quuuiur/PulseOX/WechatMiniProgram/slides_output/esp32_ble_wechat_miniprogram_lesson.pptx

从传感器到微信小程序：BLE 通信层如何搭起来

本节课只讲通信链路：为什么选 BLE、协议怎么定、两端代码怎么写。

这不是“把串口搬到手机”，而是把 ESP32 变成可订阅的数据服务。

Source: Arduino / WeChat Mini Program source code; WeChat Mini Program BLE docs

LECTURE MAP

ESP32 Peripheral

MAX30102 采样
心率/SpO2 本地计算
BLE notify 推送

脉搏血氧仪

>

SpO2

97

HR

82

ESP32 端：保留测量算法，新增 NimBLE GATT Server

小程序端：扫描、连接、订阅 notify、解析二进制包

4-byte wave + 6-byte metrics

课堂扩展：每组用独立 AppID、设备名、UUID

WeChat Mini Program

BLE Central
订阅两个 Characteristic
Canvas 绘制波形

>

01

## Slide 2

ESP32 有两条蓝牙路线，但手机端框架决定了选择。

Classic SPP 很像无线串口；BLE 是面向低功耗外设的数据服务模型。

从“发字符串”转向“定义服务、特征值和数据包”。

Source: Arduino / WeChat Mini Program source code; WeChat Mini Program BLE docs

BLUETOOTH CHOICE

维度

经典蓝牙 SPP

蓝牙 BLE

本项目判断

连接模型

点对点串口链路

Peripheral / Central + GATT

手机小程序按 GATT 连接

数据方式

连续字节流，像 Serial

Service / Characteristic / notify

波形与指标拆成两个 notify

跨平台难度

iOS 对 SPP 支持受限

iOS / Android 都有 BLE API

适合不同学生手机

功耗与频率

吞吐高但更重

适合几十 Hz 小包通知

50 点/秒波形足够

微信小程序

不能直接用 SPP

支持 BLE 低功耗接口

因此选择 BLE

手机端框架把项目推向 BLE GATT

02

## Slide 3

用微信小程序，是为了把手机端差异收敛到一个轻量框架。

Source: Arduino / WeChat Mini Program source code; WeChat Mini Program BLE docs

APP STRATEGY

原生 iOS App

Swift / 证书 / TestFlight / CoreBluetooth

>

原生 Android App

Kotlin/Java / 权限模型 / 机型差异

>

Web 页面

浏览器蓝牙能力和微信环境限制

>

微信小程序

统一入口；用真机调试 BLE；学生易分发

代价：小程序端的蓝牙能力是 BLE API，不是传统蓝牙串口。

因此 ESP32 必须做 BLE Peripheral/GATT Server；小程序作为 Central 扫描和订阅 notify。

03

## Slide 4

BLE 不是串口；它是“服务目录 + 可订阅字段”的模型。

Source: Arduino / WeChat Mini Program source code; WeChat Mini Program BLE docs

BLE MENTAL MODEL

Peripheral

ESP32-PulseOX
广播名字和 Service UUID

订阅 notify 后，ESP32 主动推送；小程序在 onBLECharacteristicValueChange 中收到 ArrayBuffer。

GATT Service

Wave Characteristic

READ | NOTIFY
4 字节波形包，约 50Hz

7D6E0001-...-3032

>

Metrics Characteristic

READ | NOTIFY
6 字节心率/血氧包

Central

微信小程序
扫描、连接、订阅

>

04

## Slide 5

测量仍在 ESP32 本地完成，BLE 只传显示层需要的数据。

Source: Arduino / WeChat Mini Program source code; WeChat Mini Program BLE docs

SYSTEM ARCHITECTURE

MAX30102

red / IR samples
400 SPS

Filters

LPF / HPF
Differentiator

Algorithm

BPM + SpO2
averaging

BLE GATT

wave notify
metrics notify

Mini Program

parse packets
update UI

Canvas + values

PPG curve
HR / SpO2

>

>

>

>

>

原串口屏链路不删除：Serial2 仍然向组态屏发送同一份波形和数值。

新增手机链路不重算算法：只在既有事件点调用 notifyWave / notifyMetrics。

05

## Slide 6

协议越小，越适合 BLE 默认 20 字节 MTU 和课堂调试。

Source: Arduino / WeChat Mini Program source code; WeChat Mini Program BLE docs

APPLICATION PROTOCOL

Wave packet: 4 bytes

含义

Metrics packet: 6 bytes

含义

Byte

0

字段

type

固定 0x01

Byte

0

字段

type

固定 0x02

1

seq

波形序号，0-255 循环

1-2

bpm

uint16 little-endian

2

3

value

flags

显示波形值，0-120

bit0: fingerDetected

由 400SPS 采样每 8 点平均一次，约 50 点/秒。

3

4

spo2

flags

uint8, 0-100

bit0 手指；bit1 指标有效

5

seq

当前波形序号

心率/血氧只在平均结果有效后推送；刚放手指会先显示 --。

二进制包比 JSON 更短、更稳定、更容易按字节讲解

06

## Slide 7

NimBLE-Arduino 负责把 ESP32 发布成一个可被订阅的 BLE 外设。

Source: Arduino / WeChat Mini Program source code; WeChat Mini Program BLE docs

ARDUINO SETUP

#include <NimBLEDevice.h>

const char *kBleDeviceName = "ESP32-PulseOX";

const char *kBleServiceUUID = "7d6e0001-...";

const char *kBleWaveCharacteristicUUID = "7d6e0002-...";

const char *kBleMetricsCharacteristicUUID = "7d6e0003-...";

NimBLEDevice::init(kBleDeviceName);

bleServer = NimBLEDevice::createServer();

NimBLEService *pulseService =

bleServer->createService(kBleServiceUUID);

waveCharacteristic = pulseService->createCharacteristic(

kBleWaveCharacteristicUUID, READ | NOTIFY, 4);

metricsCharacteristic = pulseService->createCharacteristic(

kBleMetricsCharacteristicUUID, READ | NOTIFY, 6);

第一层：身份

设备名用于学生肉眼识别；Service UUID 用于程序精确匹配。

第二层：数据字段

Wave 和 Metrics 是两个 Characteristic；都支持 READ 和 NOTIFY。

第三层：广播

advertising->addServiceUUID(...); advertising->start();

课堂讲法：先让学生在 nRF Connect 中看到服务目录，再回到小程序代码。

07

## Slide 8

BLE 发送点挂在原有测量事件上，避免维护两套算法。

Source: Arduino / WeChat Mini Program source code; WeChat Mini Program BLE docs

ARDUINO RUNTIME

readSample()

读取 red / IR

v

filter + diff

LPF / HPF / zero crossing

v

notifyWave()

4-byte 包

v

notifyMetrics()

6-byte 包

v

finger detect

red > threshold

v

PPGcount >= 8

map 到 0-120

v

avg ready

5 次心跳后

if (PPGcount >= 8) {

int display_val = map(..., -500, 500, 0, 120);

Serial2.print("add s0.id,0," + String(display_val) + ...);

notifyWave(display_val, true);

}

if (averager_bpm.count() >= kSampleThreshold) {

latestAverageBpm = average_bpm;

latestAverageSpo2 = clampInt(average_spo2, 0, 100);

notifyMetrics(latestAverageBpm, latestAverageSpo2, true, true);

}

08

## Slide 9

小程序端是一个严格的 BLE 状态机：先发现，再连接，再订阅。

代码锚点：startScan() -> connectDevice() -> discoverServices() -> discoverCharacteristics() -> subscribeNotifications()

Source: Arduino / WeChat Mini Program source code; WeChat Mini Program BLE docs

MINI PROGRAM FLOW

openBluetoothAdapter

初始化蓝牙模块

startBluetoothDevicesDiscovery

扫描附近 BLE 外设

createBLEConnection

连接 deviceId

getBLEDeviceServices

找到 Service UUID

>

>

>

getBLEDeviceCharacteristics

找到 Wave / Metrics

>

notifyBLECharacteristicValueChange

启用 notification

>

onBLECharacteristicValueChange

接收 ArrayBuffer

v

09

## Slide 10

小程序把 notify 的 ArrayBuffer 解析成 UI 状态和波形数组。

Source: Arduino / WeChat Mini Program source code; WeChat Mini Program BLE docs

MINI PROGRAM CODE

handleBleValueChange(result) {

const id = normalizeUuid(result.characteristicId)

const view = new DataView(result.value)

if (id === WAVE_CHARACTERISTIC_UUID) {

this.handleWavePacket(view)

} else if (id === METRICS_CHARACTERISTIC_UUID) {

this.handleMetricsPacket(view)

}

}

Wave parser

type=0x01
byte2 -> waveValue
byte3 bit0 -> finger

Metrics parser

type=0x02
bytes1-2 -> bpm
byte3 -> spo2

>

脉搏血氧仪

wavePoints.shift()

wavePoints.push(waveValue)

this.drawWave()

ctx.lineTo(x, y) // Canvas curve

SpO2

97

HR

82

核心观念：小程序不计算心率，只负责连接、解析、显示。

10

## Slide 11

14 个小组同时运行时，要分清“账号归属”和“蓝牙隔离”。

DEVICE_NAME_PREFIX = ESP32-PulseOX-G03 SERVICE_UUID = 7D6E0301-... WAVE = 7D6E0302-... METRICS = 7D6E0303-...

Source: Arduino / WeChat Mini Program source code; WeChat Mini Program BLE docs

CLASSROOM SCALE

AppID

决定小程序属于谁。
每组注册自己的小程序或使用测试号。

BLE name

决定人眼和扫描列表里看到哪台设备。
例如 ESP32-PulseOX-G03。

BLE UUIDs

决定程序精确连接哪组服务和特征值。
Service / Wave / Metrics 都要唯一。

G03 示例

Arduino 端和小程序端四个常量必须一一对应

11

## Slide 12

调试时不要猜，按通信链路逐层定位。

Source: Arduino / WeChat Mini Program source code; WeChat Mini Program BLE docs

DEBUGGING MAP

1. ESP32 广播

串口监视器看到 advertising；nRF Connect 能扫到设备名

2. 手机权限

手机蓝牙打开；Android 给微信定位/附近设备权限

3. Service 匹配

小程序能连接，但若提示未找到服务，检查 SERVICE_UUID

4. notify 订阅

能连接但没数据，检查 Characteristic UUID 和 notify 属性

5. 数据解析

有包但 UI 不变，检查 type 字节、长度和小端序

6. 算法输入

有波形但无 BPM/SpO2，检查手指放置、阈值、平均样本数

12
