quuuiur/PulseOX/WechatMiniProgram/slides_output/esp32_ble_wechat_miniprogram_lesson_expanded.pptx

基于蓝牙通信和微信小程序实现心率、血氧和脉搏波的手机端显示

LECTURE MAP

ESP32 Peripheral

MAX30102 采样
心率/SpO2 本地计算
BLE notify 推送

脉搏血氧仪

>

SpO2

97

HR

82

4-byte wave + 6-byte metrics

WeChat Mini Program

BLE Central
订阅两个 Characteristic
Canvas 绘制波形

>

01

## Slide 2

蓝牙先解决“近距离无线交换数据”，但不规定你一定像串口那样发。

蓝牙中涉及通用数据传输协议的有两种：
- SPP(Serial Port Profile)协议
- BLE(Bluetooth low energy)协议

BLUETOOTH FIRST PRINCIPLES

连接前

设备要让别人发现自己：名字、地址、服务线索。

连接中

两端协商角色和通信方式，决定如何交换数据。

连接后

真正的差异出现：可能是字节流，也可能是服务字段。

>

>

同一个“蓝牙”名字下面，有不同的通信模型。

本课只对比和项目有关的两种：经典蓝牙 SPP，以及 BLE GATT。

02

## Slide 3

SPP 可以先理解成：把一根串口线换成无线。

这就是很多单片机项目喜欢 SPP 的原因：思维模型接近 Serial.print。

Source: Arduino / WeChat Mini Program source code; WeChat Mini Program BLE API docs

CLASSIC BLUETOOTH SPP

单片机侧

UART TX/RX
一串连续字节
Serial.print(...)

SPP 链路

配对后像打开一个
无线串口通道

手机 App 侧

App 读取字节流
自己决定如何分包

>

>

优点：概念直观，和串口屏/串口助手很像。

难点：手机端尤其 iOS/微信小程序并不把 SPP 当作统一开放能力。

SPP 思维：我只管不停发字节

03

## Slide 4

BLE 更像“设备把数据字段公布出来，手机按需订阅”。

它不是默认给你一条连续串口流，而是鼓励低功耗、小数据包、明确字段。

Source: Arduino / WeChat Mini Program source code; WeChat Mini Program BLE API docs

BLE MENTAL MODEL

wave 字段

当前波形点
支持 READ / NOTIFY

BLE 外设

我叫 ESP32-PulseOX
我有一个 PulseOX 服务
里面有 wave 和 metrics 两个字段

>

v

手机小程序

扫描设备
连接服务
订阅字段变化
收到 notify 后刷新 UI

>

metrics 字段

心率、血氧、状态
支持 READ / NOTIFY

v

BLE GATT 思维：字段有名字、有 UUID、有权限、有通知

04

## Slide 5

BLE 连接前先分角色：谁广播，谁扫描。

本项目里 ESP32 是 Peripheral，小程序是 Central。

先广播，不代表已经连接。

小程序扫描到设备后，还要按 UUID 找到真正的数据服务。

Source: Arduino / WeChat Mini Program source code; WeChat Mini Program BLE API docs

BLE ROLES

Peripheral 外设

通常是传感器、手环、血氧仪这类设备。
它主动广播：我在这里，我叫什么，我有哪些服务。

广播包 Advertising

name = ESP32-PulseOX
service = 7D6E0001...
interval = 周期发送

Central 中心设备

通常是手机、电脑、网关。
它负责扫描、筛选、连接、发现服务、订阅数据。

>

>

05

## Slide 6

GATT 可以理解成一本“蓝牙数据目录”。

目录里不是随便放文本，而是用 UUID 标识服务和字段。

一句话：Service 是一类功能，Characteristic 是可读/可通知的数据字段，UUID 是双方约定的编号。

Source: Arduino / WeChat Mini Program source code; WeChat Mini Program BLE API docs

GATT VOCABULARY

GATT Service

Characteristic: Wave

UUID: 7D6E0002-...
Properties: READ | NOTIFY
Value: 4-byte packet

Service UUID: 7D6E0001-...

Characteristic: Metrics

UUID: 7D6E0003-...
Properties: READ | NOTIFY
Value: 6-byte packet

06

## Slide 7

SPP 和 GATT 的最大区别，不是速度，而是“数据组织方式”。

Source: Arduino / WeChat Mini Program source code; WeChat Mini Program BLE API docs

STREAM VS GATT

问题

SPP：字节流

BLE GATT：字段目录

像什么

一根无线串口线

一本可订阅的数据目录

数据怎么来

连续字节流，接收方自己切包

读字段或等待 notify 推送

双方如何识别数据

靠约定分隔符、帧头、长度

靠 Service UUID + Characteristic UUID

本项目结论

思维直观，但小程序不走这条路

和微信小程序 BLE API 对齐

讲课转折点：不要再问“串口在哪里”，而要问“字段在哪里”。

07

## Slide 8

选择微信小程序，是为了把手机端差异收敛到一个轻量框架。

Source: Arduino / WeChat Mini Program source code; WeChat Mini Program BLE API docs

APP STRATEGY

原生 iOS App

Swift / 证书 / TestFlight / CoreBluetooth

原生 Android App

Kotlin/Java / 权限模型 / 机型差异

Web 页面

浏览器蓝牙能力和微信环境限制

微信小程序

统一入口；真机调试 BLE；学生易分发

>

>

>

代价：小程序端蓝牙能力是 BLE API，不是传统蓝牙串口。

因此 ESP32 必须做 BLE Peripheral/GATT Server；小程序作为 Central 扫描和订阅 notify。

08

## Slide 9

ESP32 两种蓝牙路线都能用，但本项目被手机端框架推向 BLE。

这里的选择不是“BLE 更像串口”，而是“BLE 更适合小程序可访问的模型”。

Source: Arduino / WeChat Mini Program source code; WeChat Mini Program BLE API docs

BLUETOOTH CHOICE

维度

经典蓝牙 SPP

蓝牙 BLE

本项目判断

连接模型

点对点串口链路

Peripheral / Central + GATT

小程序按 GATT 连接

数据方式

连续字节流

Service / Characteristic / notify

波形和指标拆成字段

跨平台

iOS 与小程序受限

iOS / Android 都有 BLE API

适合学生手机差异

数据量

结论

吞吐较高

不适合作为小程序入口

适合小包、低功耗、几十 Hz

可访问、可订阅

50 点/秒波形足够

因此选择 BLE

设计结果：ESP32 做 GATT Server，小程序订阅两个 Characteristic

09

## Slide 10

测量仍在 ESP32 本地完成，BLE 只传显示层需要的数据。

Source: Arduino / WeChat Mini Program source code; WeChat Mini Program BLE API docs

SYSTEM ARCHITECTURE

MAX30102

red / IR samples
400 SPS

Filters

LPF / HPF
Differentiator

Algorithm

BPM + SpO2
averaging

BLE GATT

wave notify
metrics notify

Mini Program

parse packets
update UI

Canvas + values

PPG curve
HR / SpO2

>

>

>

>

>

原串口屏链路不删除：Serial2 继续发送同一份结果。

新增手机链路不重算算法：只在事件点调用 notify。

10

## Slide 11

协议越小，越适合 BLE 默认 20 字节 MTU 和课堂调试。

Source: Arduino / WeChat Mini Program source code; WeChat Mini Program BLE API docs

APPLICATION PROTOCOL

Wave packet: 4 bytes

含义

Metrics packet: 6 bytes

含义

Byte

0

字段

type

Byte

0

字段

type

1

seq

固定 0x01

波形序号，0-255 循环

1-2

bpm

固定 0x02

uint16 little-endian

2

3

value

flags

显示波形值，0-120

bit0: fingerDetected

3

4

spo2

flags

uint8, 0-100

bit0 手指；bit1 指标有效

5

seq

当前波形序号

二进制包比 JSON 更短，更适合高频 notify

11

## Slide 12

NimBLE-Arduino 负责把 ESP32 发布成可订阅的 BLE 外设。

Source: Arduino / WeChat Mini Program source code; WeChat Mini Program BLE API docs

ARDUINO SETUP

#include <NimBLEDevice.h>

const char *kBleDeviceName = "ESP32-PulseOX";

const char *kBleServiceUUID = "7d6e0001-...";

const char *kBleWaveCharacteristicUUID = "7d6e0002-...";

const char *kBleMetricsCharacteristicUUID = "7d6e0003-...";

NimBLEDevice::init(kBleDeviceName);

bleServer = NimBLEDevice::createServer();

NimBLEService *pulseService =

bleServer->createService(kBleServiceUUID);

waveCharacteristic = pulseService->createCharacteristic(

kBleWaveCharacteristicUUID, READ | NOTIFY, 4);

metricsCharacteristic = pulseService->createCharacteristic(

kBleMetricsCharacteristicUUID, READ | NOTIFY, 6);

第一层：身份

设备名用于学生肉眼识别；Service UUID 用于程序精确匹配。

第二层：数据字段

Wave 和 Metrics 是两个 Characteristic；都支持 READ 和 NOTIFY。

第三层：广播

advertising->addServiceUUID(...); advertising->start();

课堂讲法：先让学生在 nRF Connect 看到服务目录，再回到小程序代码。

12

## Slide 13

BLE 发送点挂在原有测量事件上，避免维护两套算法。

Source: Arduino / WeChat Mini Program source code; WeChat Mini Program BLE API docs

ARDUINO RUNTIME

readSample()

读取 red / IR

v

filter + diff

滤波和微分

v

notifyWave()

4-byte 包

v

notifyMetrics()

6-byte 包

v

finger detect

手指检测

v

PPGcount >= 8

映射到 0-120

v

avg ready

平均值有效

if (PPGcount >= 8) {

int display_val = map(..., -500, 500, 0, 120);

Serial2.print("add s0.id,0," + String(display_val) + ...);

notifyWave(display_val, true);

}

if (averager_bpm.count() >= kSampleThreshold) {

latestAverageBpm = average_bpm;

latestAverageSpo2 = clampInt(average_spo2, 0, 100);

notifyMetrics(latestAverageBpm, latestAverageSpo2, true, true);

}

13

## Slide 14

小程序端是严格的 BLE 状态机：先发现，再连接，再订阅。

代码锚点：startScan() -> connectDevice() -> discoverServices() -> discoverCharacteristics() -> subscribeNotifications()

Source: Arduino / WeChat Mini Program source code; WeChat Mini Program BLE API docs

MINI PROGRAM FLOW

openBluetoothAdapter

初始化蓝牙模块

startDiscovery

扫描 BLE 外设

createConnection

连接 deviceId

getServices

找到 Service UUID

>

>

>

onValueChange

接收 ArrayBuffer

enableNotify

启用 notification

getCharacteristics

找到 Wave / Metrics

v

14

## Slide 15

小程序把 notify 的 ArrayBuffer 解析成 UI 状态和波形数组。

Source: Arduino / WeChat Mini Program source code; WeChat Mini Program BLE API docs

MINI PROGRAM CODE

handleBleValueChange(result) {

const id = normalizeUuid(result.characteristicId)

const view = new DataView(result.value)

if (id === WAVE_CHARACTERISTIC_UUID) {

this.handleWavePacket(view)

} else if (id === METRICS_CHARACTERISTIC_UUID) {

this.handleMetricsPacket(view)

}

}

Wave parser

type=0x01
byte2 -> waveValue
byte3 bit0 -> finger

Metrics parser

type=0x02
bytes1-2 -> bpm
byte3 -> spo2

>

脉搏血氧仪

wavePoints.shift()

wavePoints.push(waveValue)

this.drawWave()

ctx.lineTo(x, y) // Canvas curve

SpO2

97

HR

82

核心观念：小程序不计算心率，只负责连接、解析、显示。

15

## Slide 16

14 个小组同时运行时，要分清“账号归属”和“蓝牙隔离”。

G03 示例： DEVICE_NAME = ESP32-PulseOX-G03 SERVICE = 7D6E0301-... WAVE = 7D6E0302-... METRICS = 7D6E0303-...

Source: Arduino / WeChat Mini Program source code; WeChat Mini Program BLE API docs

CLASSROOM SCALE

AppID

决定小程序属于谁。
每组注册自己的小程序或使用测试号。

BLE name

让学生肉眼识别周围哪台设备。
例如 ESP32-PulseOX-G03。

BLE UUIDs

让程序精确连接到本组服务。
Service / Wave / Metrics 都要唯一。

Arduino 端和小程序端必须使用同一组值

16

## Slide 17

调试时不要猜，按通信链路逐层定位。

最终目标：学生能解释“为什么 BLE、为什么两个 Characteristic、为什么 notify、为什么手机端只解析不计算”。

Source: Arduino / WeChat Mini Program source code; WeChat Mini Program BLE API docs

DEBUGGING MAP

1. ESP32 广播

串口监视器看 advertising；nRF Connect 能否看到设备名

2. 手机权限

Android 检查定位/附近设备权限；iOS 检查蓝牙开关

3. Service 匹配

小程序能连接但找不到服务时，检查 SERVICE_UUID

4. notify 订阅

能连服务但没数据，检查 Characteristic UUID 和 notify 属性

5. 数据解析

有包但 UI 不变，检查 type 字节、长度和小端序

6. 算法输入

有波形但 BPM/SpO2 慢，检查手指接触、阈值和平均策略

17

## Slide 18

记住这四句话，就能读懂本项目的蓝牙通信代码。

Source: Arduino / WeChat Mini Program source code; WeChat Mini Program BLE API docs

TAKEAWAYS

1. SPP 是无线串口思维

适合把字节连续发出去，但不适合作为微信小程序的统一入口。

2. BLE GATT 是字段订阅思维

先定义服务和特征值，再让手机订阅特征值变化。

3. Arduino 端负责发布数据

NimBLE 创建 Service 和 Characteristics，算法事件触发 notify。

4. 小程序端负责连接和显示

扫描、连接、订阅、解析 ArrayBuffer，再更新数值和 Canvas 波形。

从“发串口字符串”升级到“设计一个小型数据服务”

18
