quuuiur/PulseOX/SerialScreen/Reference_480x272/tjc_t1_480x272_pulseox_background.bmp

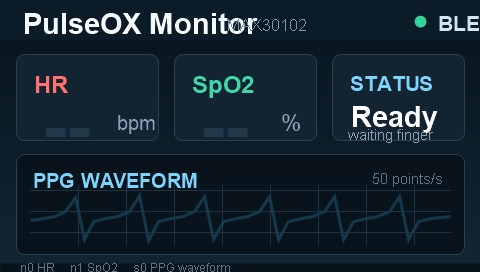
SerialScreen/Reference_480x272/tjc_t1_480x272_pulseox_background.bmp
