quuuiur/PulseOX/原理图_layout/SCH_Schematic3_2026-06-06.pdf

ESP-32主控 | 排针引出
串口屏连接 | 血氧心率max30102

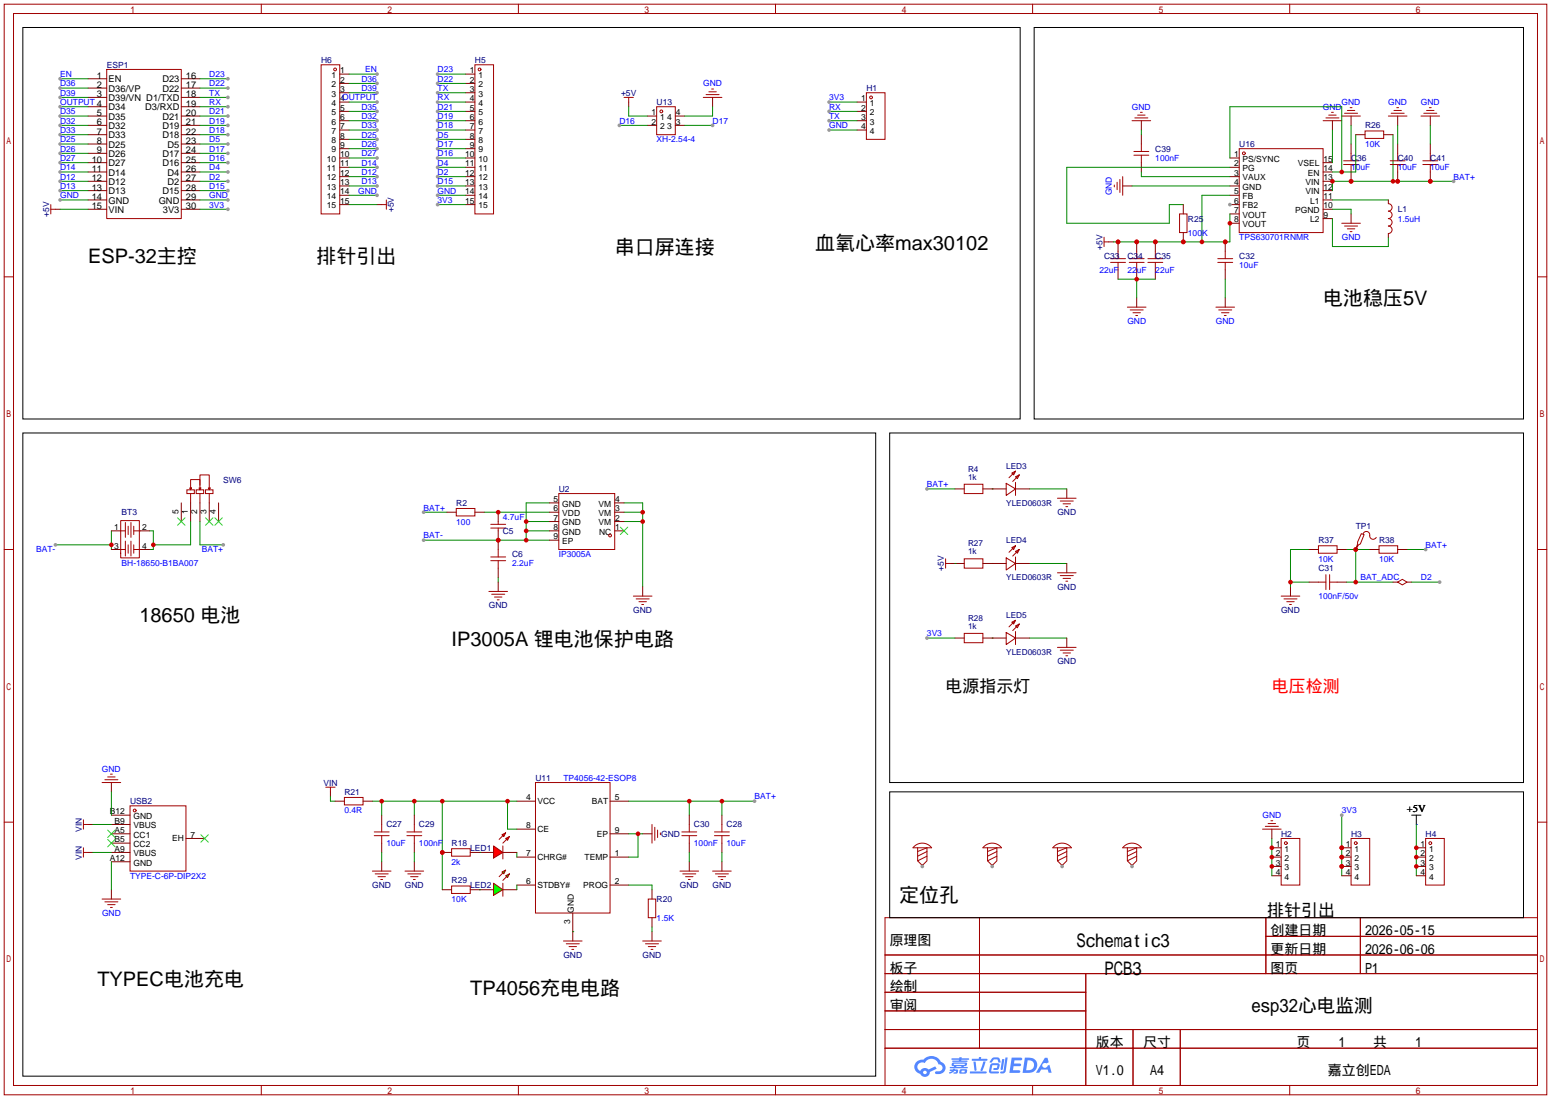
[picture p3: page 1]

原理图 | Schematic3 | 创建日期 | 2026-05-15

更新日期 | 2026-06-06

板子 | PCB3 | 图页 | P1
绘制 | | esp32心电监测
审阅

V1.0 | A4 | 嘉立创EDA
