quuuiur/PulseOX/原理图_layout/PCB_PCB3_2026-06-06.pdf

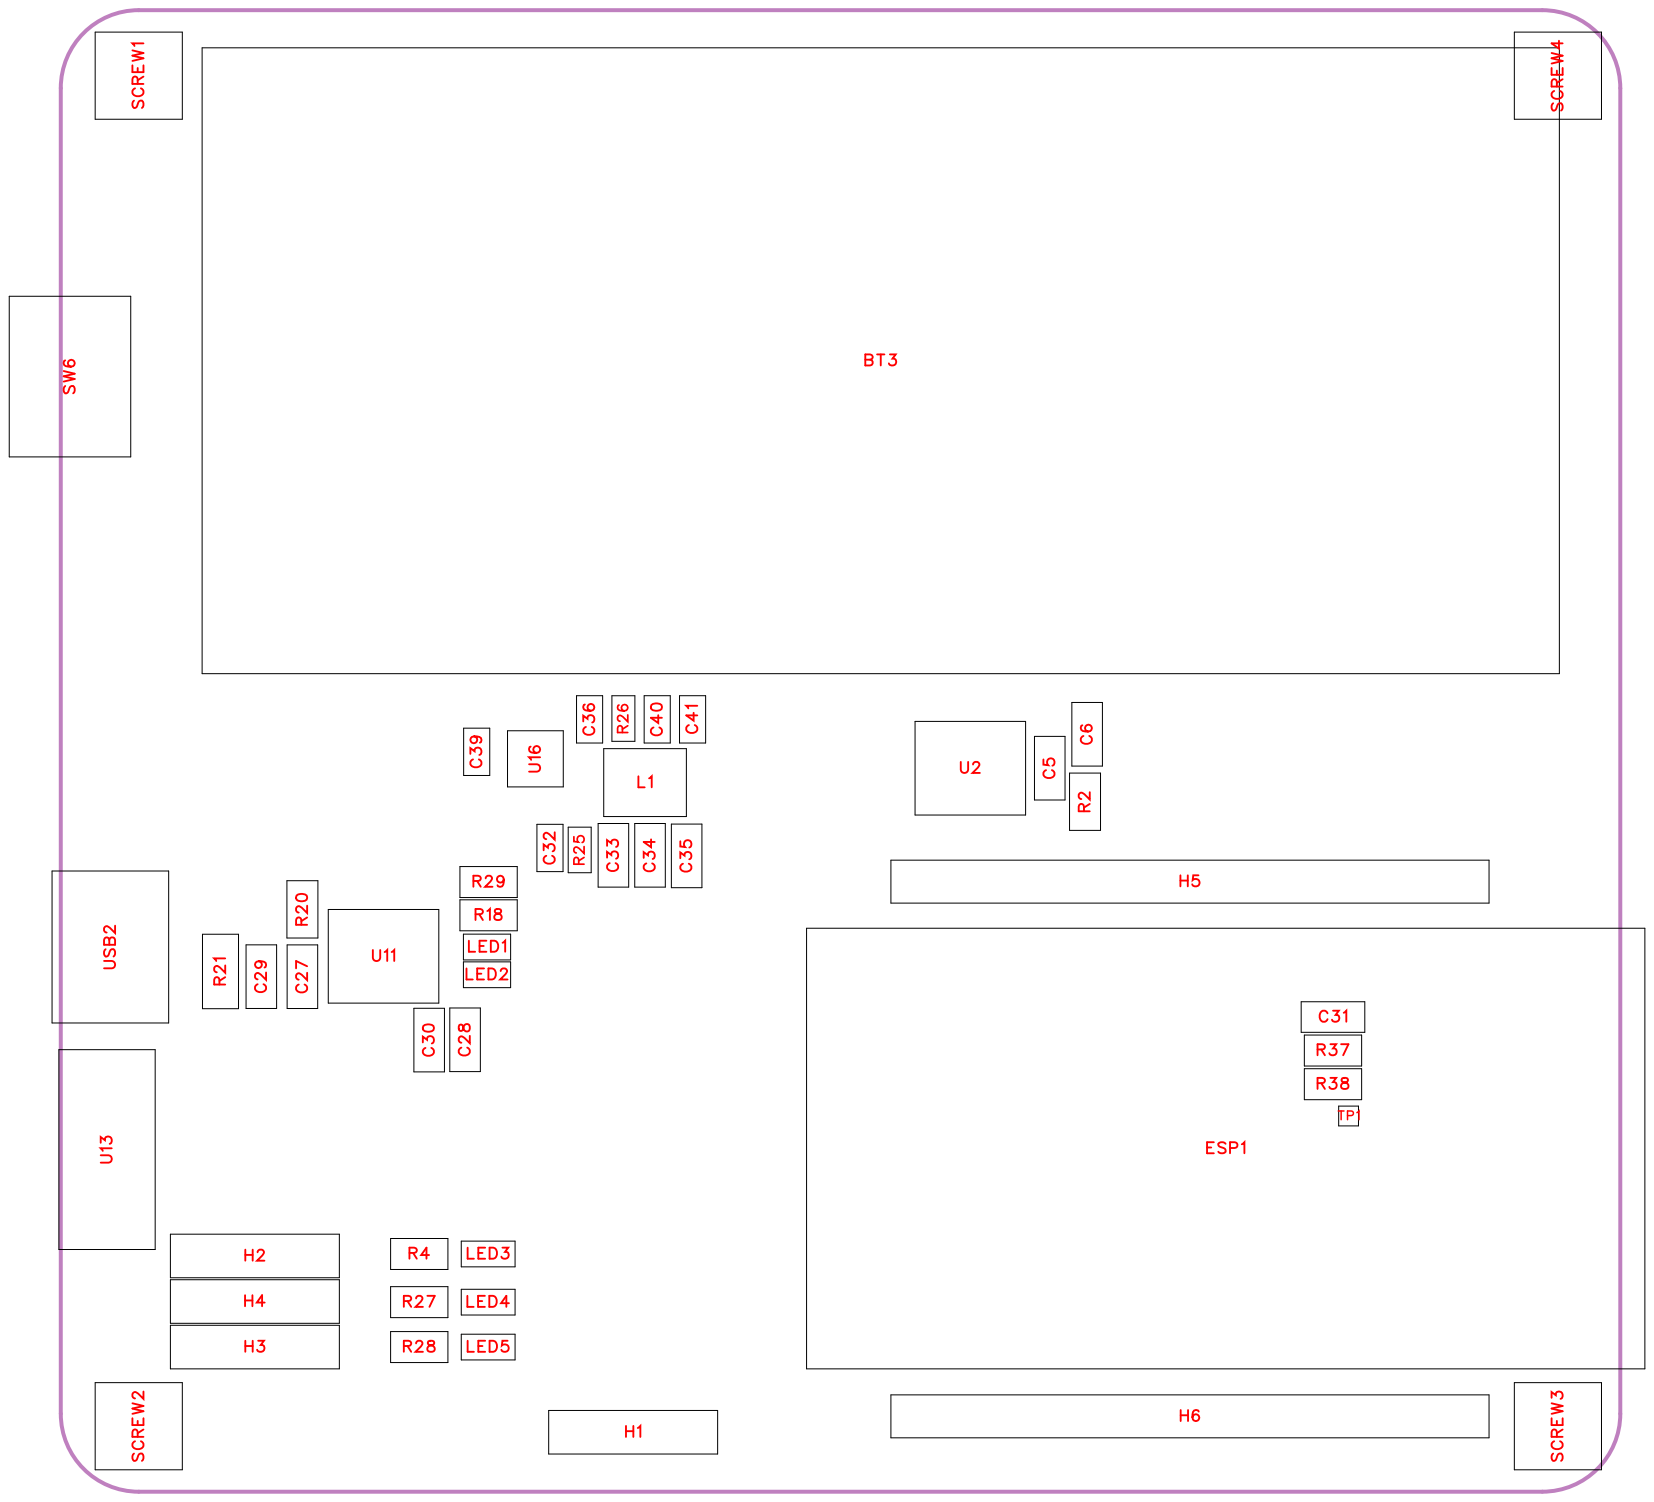
[picture p4: page 1]

No. | Quantity | Comment | Designator | Footprint | Value | Manufacturer Part | Manufacturer | Supplier Part | Supplier
1 | 1 | BH-18650-B1 BA007 | BT3 | BAT-SMD_B H-18650-B1B A007 | | BH-18650-B1 BA007 | MYOUNG(美 阳) | C6937126 | LCSC
2 | 1 | 4.7uF | C5 | C0805 | 4.7uF | CL21A475KA QNNNE | SAMSUNG( 三星) | C1779 | LCSC
3 | 1 | 2.2uF | C6 | C0805 | 2.2uF | CL21A225KB QNNNE | SAMSUNG( 三星) | C377773 | LCSC
4 | 2 | 10uF | C27,C28 | C0805 | 10uF
5 | 2 | 100nF | C29,C30 | C0805 | 100nF
6 | 1 | 100nF/50v | C31 | C0805 | 100nF/50v
7 | 4 | 10uF | C32,C36,C40,C41 | C0603 | 10uF
8 | 3 | 22uF | C33,C34,C35 | C0805 | 22uF
9 | 1 | 100nF | C39 | C0603 | 100nF
10 | 1 | ESP32DevKit | ESP1 | ESP32-DEV KIT3
11 | 4 | HDR-F_2.54 _1x4P | H1,H2,H3,H4 | HDR-TH_4P-P2.54-V-F | | | | C2718488
12 | 2 | HDR-M_2.54 _1x15P | H5,H6 | HDR-TH_15 P-P2.54-V-M | | | | C124373
13 | 1 | 1.5uH | L1 | IND-SMD_L4 .6-W4.1_SR G0420 | 1.5uH | SRG0420-1R 5-M | JIERR(捷而 瑞) | C53462915 | LCSC
14 | 1 | LED_0603-R | LED1 | LED_0603
15 | 1 | LED_0603-G | LED2 | LED_0603
16 | 3 | YLED0603R | LED3,LED4,LED5 | LED0603-FD | | YLED0603R | YONGYUTAI (永裕泰) | C19171390 | LCSC
17 | 1 | 100 | R2 | R0805 | 100 | 0603WAF10 00T5E | UNI-ROYAL( 厚声) | C22775 | LCSC
18 | 3 | 1k | R4,R27,R28 | R0805
19 | 1 | 2k | R18 | R0805 | 2k | 0805W8J020 2T5E | UNI-ROYAL( 厚声) | C1359 | LCSC
20 | 1 | 1.5K | R20 | R0805 | 1.5K
21 | 1 | 0.4R | R21 | R1206 | 0.4R
22 | 1 | 100K | R25 | R0603 | 100K
23 | 1 | 10K | R26 | R0603 | 10K
24 | 3 | 10K | R29,R37,R38 | R0805 | 10K
25 | 4 | M3螺丝 | SCREW1,SCREW2,SCRE W3,SCREW4 | M3螺丝
26 | 1 | SK12D07VG 3 | SW6 | SW-TH_SK1 2D07VG3 | | SK12D07VG 3 | SHOU HAN(首韩) | C431547 | LCSC
27 | 1 | Test-Point | TP1 | Test-Point-0. 5mm

28 | 1 | IP3005A | U2 | ESOP-8_L4. 9-W3.9-P1.2 7-LS6.0-BL-E P | IP3005A | INJOINIC( 英 集芯 ) | C181685 | LCSC
29 | 1 | TP4056-42-E SOP8 | U11 | ESOP-8_L4. 9-W3.9-P1.2 7-LS6.0-BL-E P | TP4056-42-E SOP8 | TOPPOWER (南京拓微) | C16581 | LCSC
30 | 1 | XH-2.54-4 | U13 | CONN-TH_X H-2.54-4 | XH-2.54-4 | | C990000523 0 | LCSC
31 | 1 | TPS630701R NMR | U16 | VQFN-HR-15 _L3.0-W2.5-P0.50-BL_TP S63070RNM R | TPS630701R NMR | TI(德州仪器 ) | C2876599 | LCSC
32 | 1 | TYPE-C-6P-DIP2X2 | USB2 | TYPE-C-SM D_TYPE-C-6 P | TYPE-C-6P-DIP2X2 | | C990001762 7 | LCSC

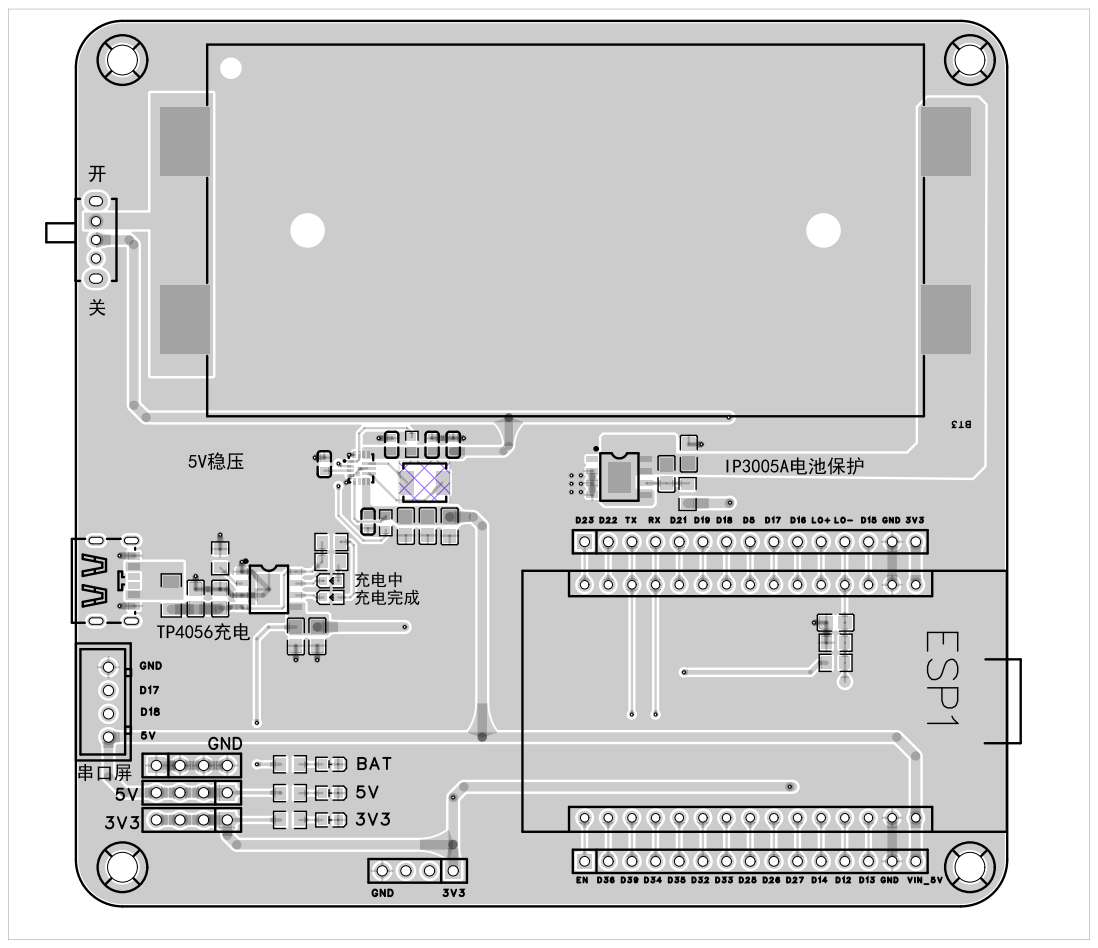
[picture p5: page 5]

D23 D22 TX RX D21 D19 D18 D5 D17 D16 LO+ LO- D15 GND 3V3

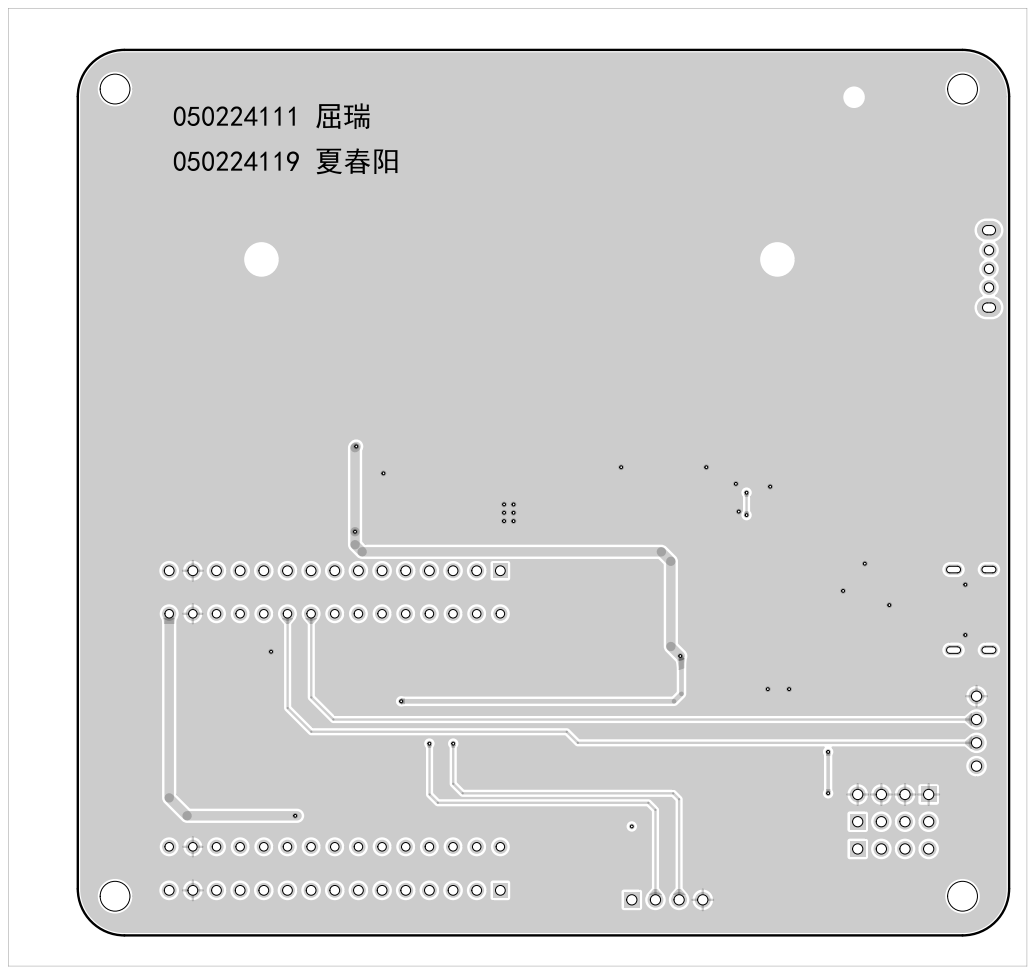
[picture p6: page 6]

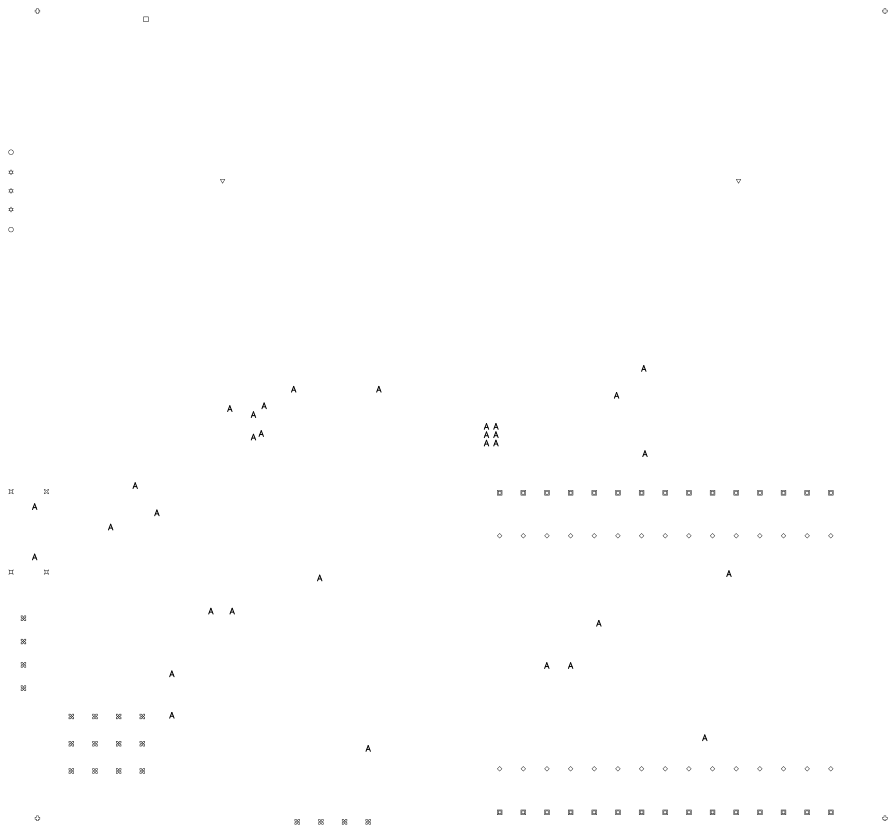
[picture p7: page 7]
