quuuiur/PulseOX/(commit log)

2026-06-06 Initial commit: PulseOX pulse oximeter project with Arduino, BLE, serial screen and WeChat mini program
2026-06-06 Add PCB layout and schematic PDFs
